york-fs/bms/README.md

# Battery Management System Segment Board





The distributed BMS segment board connects to a series string of 12 cells and can be queried over isolated I2C to sample
cell voltages and temperatures.

## Features

* **Isolated I2C Communication to the Master Board**
* **Accurate Voltage Measurement Using the MAX14920 Analog Frontend**
* **Passive Cell Balancing**
* **Up to 23 Connected Thermistors**
  * Three onboard thermistors around the cell balancers
  * Twenty external thermistors across two JST PUD connectors

Preview Render

## Cloning

A recursive clone must be used to download the `kicad-library` repository:

    git clone --recursive https://github.com/york-fs/bms-segment.git
