york-fs/bms/bms_segment.kicad_pcb

## KiCad design bms_segment.kicad_pcb (2025-10-20)

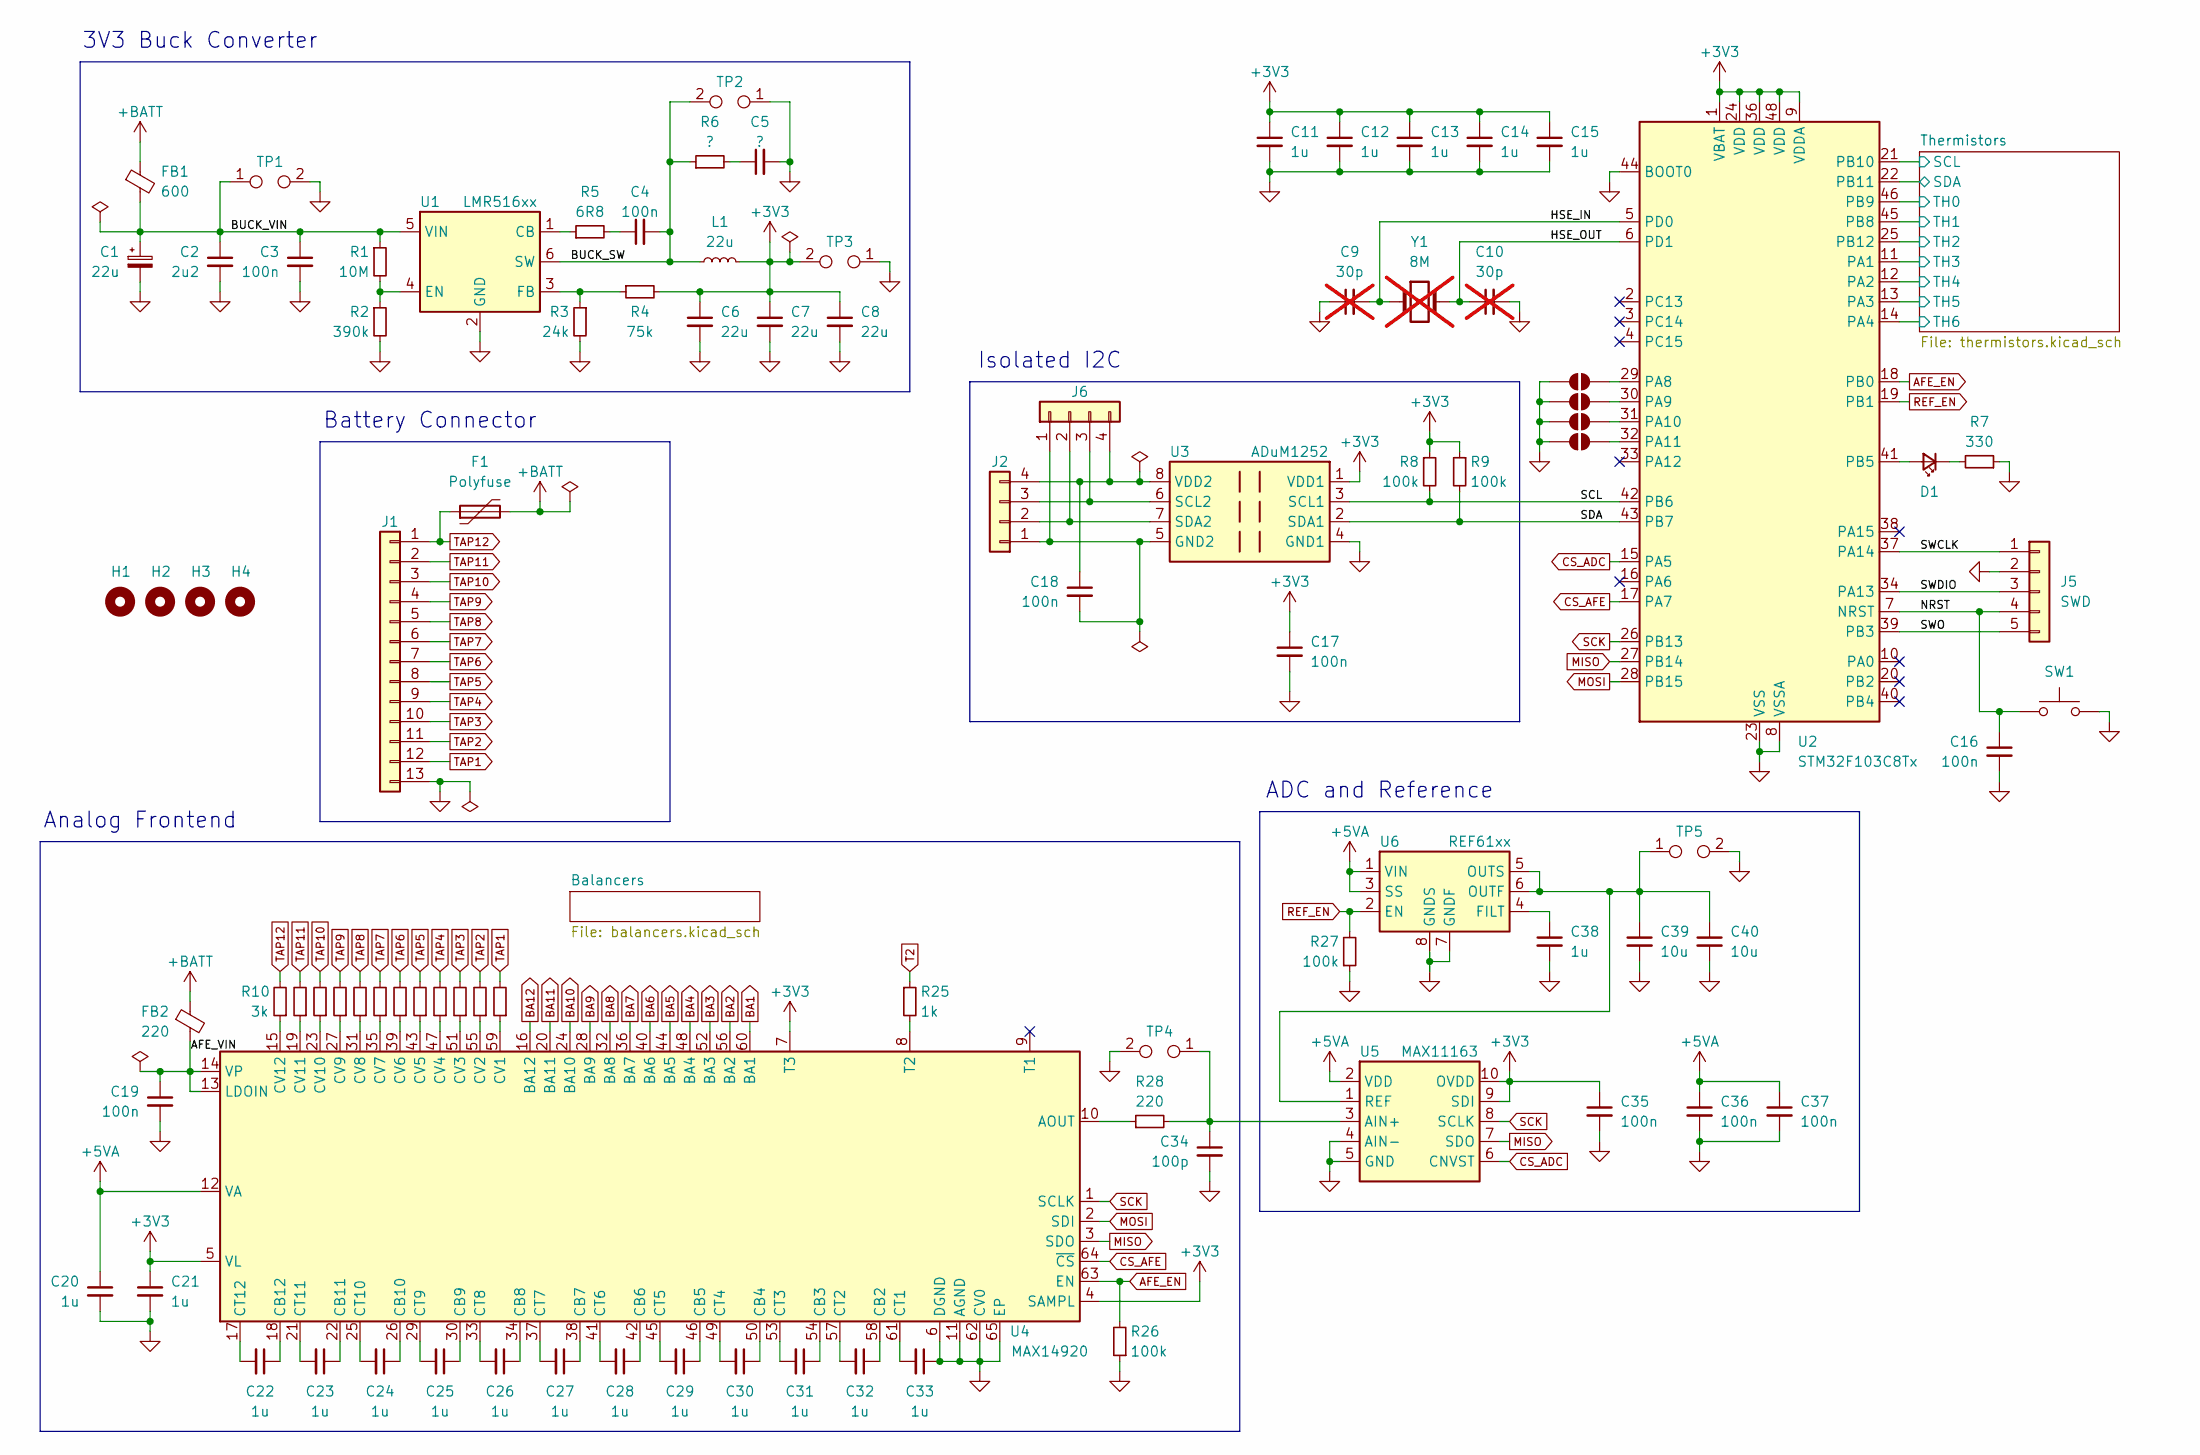
[picture p1: schematic bms_segment.kicad_sch, Battery Management System]

Parts:
C1: 22u; CP_Elec_6.3x7.7; Mfr # EEEFK1J220XP
C2: 2u2; C_1210_3225Metric; Mfr # GRM32ER72A225KA35
C3, C19: 100n; C_1206_3216Metric; Mfr # GRM31C5C2A104JA01L
C4, C16, C17, C18, C35, C36, C37: 100n; C_0603_1608Metric; Mfr # CL10B104KB8NNNC
C5: ?; C_0603_1608Metric
C6, C7, C8: 22u; C_1210_3225Metric; Mfr # GRM32ER71E226KE15L
C9, C10: 30p; C_0603_1608Metric; Mfr # GQM1875C2E300GB12D; not fitted
C11, C12, C13, C14, C15, C20, C21, C38: 1u; C_0603_1608Metric; Mfr # CL10B105KB8NQNC
C22, C23, C24, C25, C26, C27, C28, C29, C30, C31, C32, C33: 1u; C_0805_2012Metric; Mfr # GCM21BR71H105KA03L
C34: 100p; C_0603_1608Metric
C39, C40: 10u; C_1206_3216Metric; Mfr # GRM31CR71C106KA12L
D1: LED_Small; LED_0603_1608Metric; Mfr # NCD0603R1
F1: Polyfuse; R_1206_3216Metric; Mfr # 1206L010/60WR
FB1: 600; L_0603_1608Metric; Mfr # BLM18KG601SN1D
FB2: 220; L_0603_1608Metric; Mfr # BLM18PG221SN1D
H1, H2, H3, H4: MountingHole; MountingHole_3.2mm_M3
J1: CELL_TAPS; PhoenixContact_MC_1,5_13-G-3.81_1x13_P3.81mm_Horizontal; Mfr # MX15EDGRC-3.81-13P-GN01-Cu-A
J2, J6: I2C; JST_PH_B4B-PH-K_1x04_P2.00mm_Vertical; Mfr # B4B-PH-K-S(LF)(SN)
J5: SWD; PinHeader_1x05_P2.54mm_Vertical
JP1, JP2, JP3, JP4: SolderJumper_2_Open; SolderJumper-2_P1.3mm_Open_RoundedPad1.0x1.5mm
L1: 22u; L_Vishay_IHLP-2525; Mfr # IHLP2525CZER220M1A
R1: 10M; R_0603_1608Metric
R2: 390k; R_0603_1608Metric
R3: 24k; R_0603_1608Metric
R4: 75k; R_0603_1608Metric
R5: 6R8; R_0603_1608Metric
R6: ?; R_0603_1608Metric
R7: 330; R_0603_1608Metric; Mfr # 0603WAF3300T5E
R8, R9, R26, R27: 100k; R_0603_1608Metric; Mfr # 0603WAF1003T5E
R10, R11, R12, R13, R14, R15, R16, R17, R18, R19, R20, R21: 3k; R_0603_1608Metric; Mfr # 0603WAF3001T5E
R25: 1k; R_0603_1608Metric; Mfr # 0603WAF1001T5E
R28: 220; R_0603_1608Metric
SW1: SW_Push; SW_Push_SPST_NO_Alps_SKRK; Mfr # TS-1088-AR02016
TP1, TP2, TP3, TP4, TP5: TestPoint_2Pole; TestPoint_2Pads_Pitch2.54mm_Drill1.0mm
U1: LMR516xx; SOT-23-6; Mfr # LMR51606XDBVR
U2: STM32F103C8Tx; LQFP-48_7x7mm_P0.5mm; Mfr # STM32F103C8T6
U3: ADuM1252; MSOP-8_3x3mm_P0.65mm; Mfr # ADUM1252AUA+
U4: MAX14920; TQFP-64-1EP_10x10mm_P0.5mm_EP5.305x5.305mm; Mfr # MAX14920ECB+
U5: MAX11163; MSOP-10_3x3mm_P0.5mm; Mfr # MAX11163EUB+
U6: REF61xx; VSSOP-8_3x3mm_P0.65mm; Mfr # REF6145IDGKT
Y1: 8M; Crystal_SMD_5032-2Pin_5.0x3.2mm; Mfr # X50328MSB2GI; not fitted

Connections:
+3V3: C6.1, C7.1, C8.1, C11.1, C12.1, C13.1, C14.1, C15.1, C17.1, C21.1, C35.1, L1.2, R4.2, R8.1, R9.1, TP3.2, U2.1 (VBAT), U2.9 (VDDA), U2.24 (VDD), U2.36 (VDD), U2.48 (VDD), U3.1 (VDD1), U4.4 (SAMPL), U4.5 (VL), U4.7 (T3), U5.9 (SDI), U5.10 (OVDD); also elsewhere on the board
+5VA: C20.1, C36.1, C37.1, U4.12 (VA), U5.2 (VDD), U6.1 (VIN), U6.3 (SS)
+BATT: F1.2, FB1.1, FB2.1
/AFE_VIN: C19.1, FB2.2, U4.13 (LDOIN), U4.14 (VP)
/BUCK_SW: C4.2, L1.1, R6.1, TP2.2, U1.6 (SW)
/BUCK_VIN: C1.1, C2.1, C3.1, FB1.2, R1.1, TP1.1, U1.5 (VIN)
/HSE_IN: C9.2, U2.5 (PD0), Y1.1
/HSE_OUT: C10.1, U2.6 (PD1), Y1.2
/NRST: C16.1, J5.4, SW1.1, U2.7 (NRST)
/SCL: R8.2, U2.42 (PB6), U3.3 (SCL1)
/SDA: R9.2, U2.43 (PB7), U3.2 (SDA1)
/SWCLK: J5.1, U2.37 (PA14)
/SWDIO: J5.3, U2.34 (PA13)
/SWO: J5.5, U2.39 (PB3)
/Thermistors/SCL: U2.21 (PB10); also elsewhere on the board
/Thermistors/SDA: U2.22 (PB11); also elsewhere on the board
/Thermistors/TH0: U2.46 (PB9); also elsewhere on the board
/Thermistors/TH1: U2.45 (PB8); also elsewhere on the board
/Thermistors/TH2: U2.25 (PB12); also elsewhere on the board
/Thermistors/TH3: U2.11 (PA1); also elsewhere on the board
/Thermistors/TH4: U2.12 (PA2); also elsewhere on the board
/Thermistors/TH5: U2.13 (PA3); also elsewhere on the board
/Thermistors/TH6: U2.14 (PA4); also elsewhere on the board
AFE_EN: R26.2, U2.18 (PB0), U4.63 (EN)
BA1: U4.60 (BA1); also elsewhere on the board
BA2: U4.56 (BA2); also elsewhere on the board
BA3: U4.52 (BA3); also elsewhere on the board
BA4: U4.48 (BA4); also elsewhere on the board
BA5: U4.44 (BA5); also elsewhere on the board
BA6: U4.40 (BA6); also elsewhere on the board
BA7: U4.36 (BA7); also elsewhere on the board
BA8: U4.32 (BA8); also elsewhere on the board
BA9: U4.28 (BA9); also elsewhere on the board
BA10: U4.24 (BA10); also elsewhere on the board
BA11: U4.20 (BA11); also elsewhere on the board
BA12: U4.16 (BA12); also elsewhere on the board
CS_ADC: U2.15 (PA5), U5.6 (CNVST)
CS_AFE: U2.17 (PA7), U4.64 (~CS)
GND: C1.2, C2.2, C3.2, C5.2, C6.2, C7.2, C8.2, C9.1, C10.2, C11.2, C12.2, C13.2, C14.2, C15.2, C16.2, C17.2, C19.2, C20.2, C21.2, C33.1, C34.2, C35.2, C36.2, C37.2, C38.2, C39.2, C40.2, J1.13, J5.2, JP1.1 (A), JP2.1 (A), JP3.1 (A), JP4.1 (A), R2.2, R3.2, R7.1, R26.1, R27.1, SW1.2, TP1.2, TP2.1, TP3.1, TP4.2, TP5.2, U1.2 (GND), U2.8 (VSSA), U2.23 (VSS), U2.35 (VSS), U2.44 (BOOT0), U2.47 (VSS), U3.4 (GND1), U4.6 (DGND), U4.11 (AGND), U4.62 (CV0), U4.65 (EP), U5.4 (AIN-), U5.5 (GND), U6.7 (GNDF), U6.8 (GNDS); also elsewhere on the board
MISO: U2.27 (PB14), U4.3 (SDO), U5.7 (SDO)
MOSI: U2.28 (PB15), U4.2 (SDI)
unnamed: C4.1, R5.2
unnamed: C5.1, R6.2
unnamed: D1.2 (A), U2.41 (PB5)
unnamed: D1.1 (K), R7.2
unnamed: C18.2, J2.1, J6.1, U3.5 (GND2)
unnamed: J2.2, J6.2, U3.7 (SDA2)
unnamed: J2.3, J6.3, U3.6 (SCL2)
unnamed: C18.1, J2.4, J6.4, U3.8 (VDD2)
unnamed: JP1.2 (B), U2.29 (PA8)
unnamed: JP2.2 (B), U2.30 (PA9)
unnamed: JP3.2 (B), U2.31 (PA10)
unnamed: JP4.2 (B), U2.32 (PA11)
unnamed: R5.1, U1.1 (CB)
unnamed: R1.2, R2.1, U1.4 (EN)
unnamed: R3.1, R4.1, U1.3 (FB)
unnamed: R28.1, U4.10 (AOUT)
unnamed: C32.1, U4.58 (CB2)
unnamed: C31.1, U4.54 (CB3)
unnamed: C30.1, U4.50 (CB4)
unnamed: C29.1, U4.46 (CB5)
unnamed: C28.1, U4.42 (CB6)
unnamed: C27.1, U4.38 (CB7)
unnamed: C26.1, U4.34 (CB8)
unnamed: C25.1, U4.30 (CB9)
unnamed: C24.1, U4.26 (CB10)
unnamed: C23.1, U4.22 (CB11)
unnamed: C22.1, U4.18 (CB12)
unnamed: C33.2, U4.61 (CT1)
unnamed: C32.2, U4.57 (CT2)
unnamed: C31.2, U4.53 (CT3)
unnamed: C30.2, U4.49 (CT4)
unnamed: C29.2, U4.45 (CT5)
unnamed: C28.2, U4.41 (CT6)
unnamed: C27.2, U4.37 (CT7)
unnamed: C26.2, U4.33 (CT8)
unnamed: C25.2, U4.29 (CT9)
unnamed: C24.2, U4.25 (CT10)
unnamed: C23.2, U4.21 (CT11)
unnamed: C22.2, U4.17 (CT12)
unnamed: R21.1, U4.59 (CV1)
unnamed: R20.1, U4.55 (CV2)
unnamed: R19.1, U4.51 (CV3)
unnamed: R18.1, U4.47 (CV4)
unnamed: R17.1, U4.43 (CV5)
unnamed: R16.1, U4.39 (CV6)
unnamed: R15.1, U4.35 (CV7)
unnamed: R14.1, U4.31 (CV8)
unnamed: R13.1, U4.27 (CV9)
unnamed: R12.1, U4.23 (CV10)
unnamed: R11.1, U4.19 (CV11)
unnamed: R10.1, U4.15 (CV12)
unnamed: R25.2, U4.8 (T2)
unnamed: C34.1, R28.2, TP4.1, U5.3 (AIN+)
unnamed: C39.1, C40.1, TP5.1, U5.1 (REF), U6.5 (OUTS), U6.6 (OUTF)
unnamed: C38.1, U6.4 (FILT)
REF_EN: R27.2, U2.19 (PB1), U6.2 (EN)
SCK: U2.26 (PB13), U4.1 (SCLK), U5.8 (SCLK)
T2: R25.1; also elsewhere on the board
TAP1: J1.12, R21.2; also elsewhere on the board
TAP2: J1.11, R20.2; also elsewhere on the board
TAP3: J1.10, R19.2; also elsewhere on the board
TAP4: J1.9, R18.2; also elsewhere on the board
TAP5: J1.8, R17.2; also elsewhere on the board
TAP6: J1.7, R16.2; also elsewhere on the board
TAP7: J1.6, R15.2; also elsewhere on the board
TAP8: J1.5, R14.2; also elsewhere on the board
TAP9: J1.4, R13.2; also elsewhere on the board
TAP10: J1.3, R12.2; also elsewhere on the board
TAP11: J1.2, R11.2; also elsewhere on the board
TAP12: F1.1, J1.1, R10.2; also elsewhere on the board

Notes on the sheet:
ADC and Reference
Isolated I2C
3V3 Buck Converter
Analog Frontend
Battery Connector

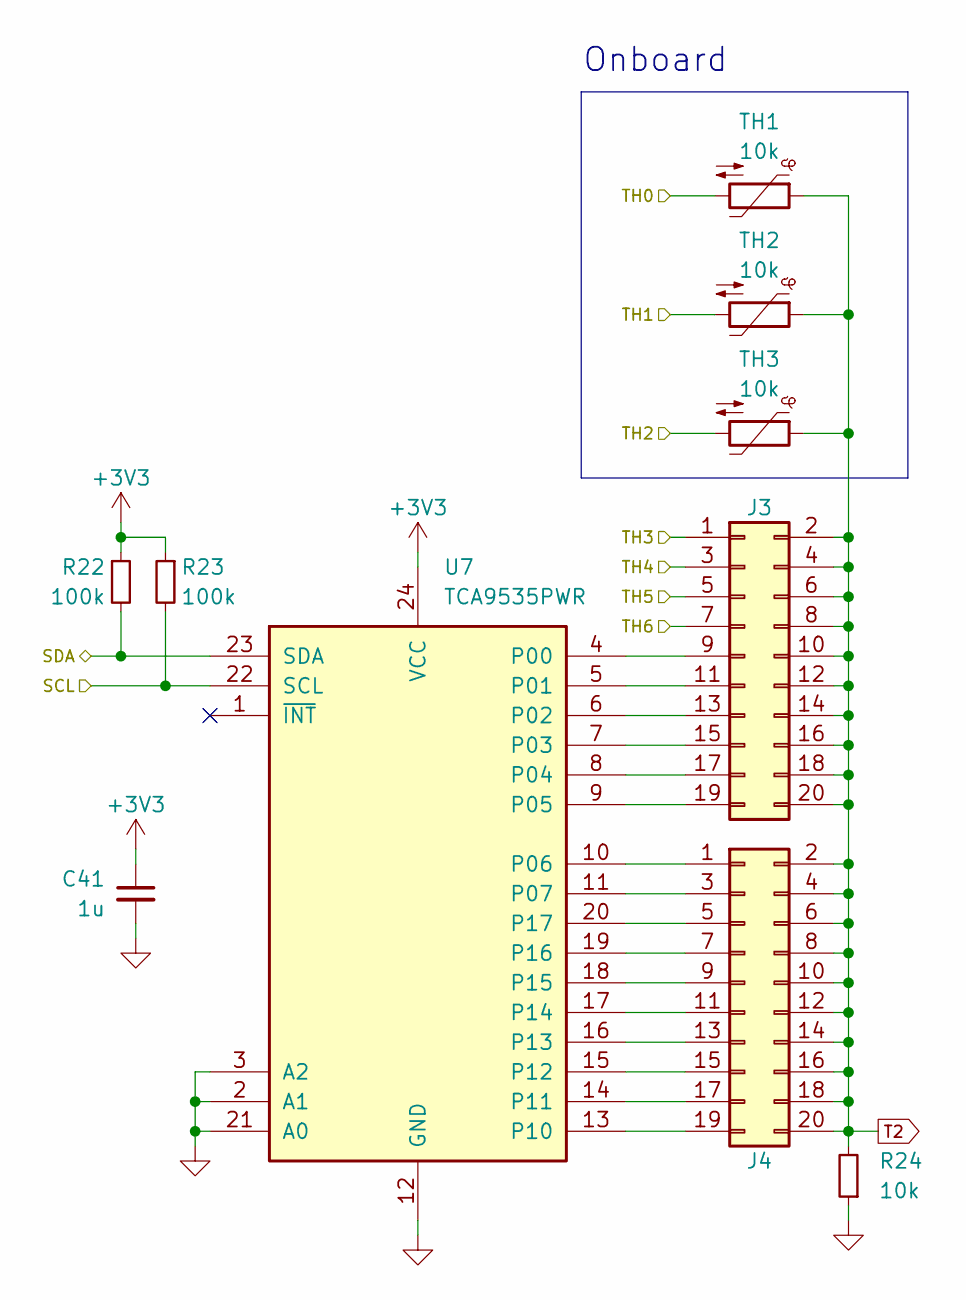
[picture p2: schematic thermistors.kicad_sch, Battery Management System]

Parts:
C41: 1u; C_0603_1608Metric; Mfr # CL10B105KB8NQNC
J3: THERM_1; JST_PUD_S20B-PUDSS-1_2x10_P2.00mm_Horizontal; Mfr # S20B-PUDSS-1(LF)(SN)
J4: THERM_2; JST_PUD_S20B-PUDSS-1_2x10_P2.00mm_Horizontal; Mfr # S20B-PUDSS-1(LF)(SN)
R22, R23: 100k; R_0603_1608Metric; Mfr # 0603WAF1003T5E
R24: 10k; R_0603_1608Metric; Mfr # 0603WAF1002T5E
TH1, TH2, TH3: 10k; R_0603_1608Metric; Mfr # NCP18XH103F03RB
U7: TCA9535PWR; TSSOP-24_4.4x7.8mm_P0.65mm; Mfr # TCA9535PWR

Connections:
+3V3: C41.1, R22.1, R23.1, U7.24 (VCC); also elsewhere on the board
/Thermistors/SCL: R23.2, U7.22 (SCL); also elsewhere on the board
/Thermistors/SDA: R22.2, U7.23 (SDA); also elsewhere on the board
/Thermistors/TH0: TH1.2; also elsewhere on the board
/Thermistors/TH1: TH2.2; also elsewhere on the board
/Thermistors/TH2: TH3.2; also elsewhere on the board
/Thermistors/TH3: J3.1; also elsewhere on the board
/Thermistors/TH4: J3.3; also elsewhere on the board
/Thermistors/TH5: J3.5; also elsewhere on the board
/Thermistors/TH6: J3.7; also elsewhere on the board
GND: C41.2, R24.1, U7.2 (A1), U7.3 (A2), U7.12 (GND), U7.21 (A0); also elsewhere on the board
unnamed: J3.9, U7.4 (P00)
unnamed: J3.11, U7.5 (P01)
unnamed: J3.13, U7.6 (P02)
unnamed: J3.15, U7.7 (P03)
unnamed: J3.17, U7.8 (P04)
unnamed: J3.19, U7.9 (P05)
unnamed: J4.1, U7.10 (P06)
unnamed: J4.3, U7.11 (P07)
unnamed: J4.5, U7.20 (P17)
unnamed: J4.7, U7.19 (P16)
unnamed: J4.9, U7.18 (P15)
unnamed: J4.11, U7.17 (P14)
unnamed: J4.13, U7.16 (P13)
unnamed: J4.15, U7.15 (P12)
unnamed: J4.17, U7.14 (P11)
unnamed: J4.19, U7.13 (P10)
T2: J3.2, J3.4, J3.6, J3.8, J3.10, J3.12, J3.14, J3.16, J3.18, J3.20, J4.2, J4.4, J4.6, J4.8, J4.10, J4.12, J4.14, J4.16, J4.18, J4.20, R24.2, TH1.1, TH2.1, TH3.1; also elsewhere on the board

Notes on the sheet:
Onboard

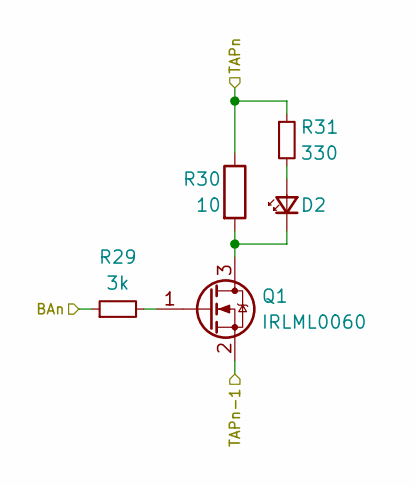
[picture p3: schematic balance.kicad_sch, Battery Management System]

Parts:
D2: LED_Small; LED_0603_1608Metric; Mfr # NCD0603R1
Q1: IRLML0060; SOT-23; Mfr # IRLML0060TRPBF
R29: 3k; R_0603_1608Metric; Mfr # 0603WAF3001T5E
R30: 10; R_2512_6332Metric; Mfr # RPL-12K10R0FT
R31: 330; R_0603_1608Metric; Mfr # 0603WAF3300T5E

Connections:
BA1: R29.1; also elsewhere on the board
GND: Q1.2 (S); also elsewhere on the board
unnamed: D2.2 (A), R31.2
unnamed: D2.1 (K), Q1.3 (D), R30.2
unnamed: Q1.1 (G), R29.2
TAP1: R30.1, R31.1; also elsewhere on the board

Parts of its further copies:
D3, D4, D5, D6, D7, D8, D9, D10, D11, D12, D13: LED_Small; LED_0603_1608Metric; Mfr # NCD0603R1
Q2, Q3, Q4, Q5, Q6, Q7, Q8, Q9, Q10, Q11, Q12: IRLML0060; SOT-23; Mfr # IRLML0060TRPBF
R32, R35, R38, R41, R44, R47, R50, R53, R56, R59, R62: 3k; R_0603_1608Metric; Mfr # 0603WAF3001T5E
R33, R36, R39, R42, R45, R48, R51, R54, R57, R60, R63: 10; R_2512_6332Metric; Mfr # RPL-12K10R0FT
R34, R37, R40, R43, R46, R49, R52, R55, R58, R61, R64: 330; R_0603_1608Metric; Mfr # 0603WAF3300T5E

Connections of its further copies:
BA2: R32.1; also elsewhere on the board
BA3: R35.1; also elsewhere on the board
BA4: R38.1; also elsewhere on the board
BA5: R41.1; also elsewhere on the board
BA6: R44.1; also elsewhere on the board
BA7: R47.1; also elsewhere on the board
BA8: R50.1; also elsewhere on the board
BA9: R53.1; also elsewhere on the board
BA10: R56.1; also elsewhere on the board
BA11: R59.1; also elsewhere on the board
BA12: R62.1; also elsewhere on the board
unnamed: D3.2 (A), R34.2
unnamed: D3.1 (K), Q2.3 (D), R33.2
unnamed: D4.2 (A), R37.2
unnamed: D4.1 (K), Q3.3 (D), R36.2
unnamed: D5.2 (A), R40.2
unnamed: D5.1 (K), Q4.3 (D), R39.2
unnamed: D6.2 (A), R43.2
unnamed: D6.1 (K), Q5.3 (D), R42.2
unnamed: D7.2 (A), R46.2
unnamed: D7.1 (K), Q6.3 (D), R45.2
unnamed: D8.2 (A), R49.2
unnamed: D8.1 (K), Q7.3 (D), R48.2
unnamed: D9.2 (A), R52.2
unnamed: D9.1 (K), Q8.3 (D), R51.2
unnamed: D10.2 (A), R55.2
unnamed: D10.1 (K), Q9.3 (D), R54.2
unnamed: D11.2 (A), R58.2
unnamed: D11.1 (K), Q10.3 (D), R57.2
unnamed: D12.2 (A), R61.2
unnamed: D12.1 (K), Q11.3 (D), R60.2
unnamed: D13.2 (A), R64.2
unnamed: D13.1 (K), Q12.3 (D), R63.2
unnamed: Q2.1 (G), R32.2
unnamed: Q3.1 (G), R35.2
unnamed: Q4.1 (G), R38.2
unnamed: Q5.1 (G), R41.2
unnamed: Q6.1 (G), R44.2
unnamed: Q7.1 (G), R47.2
unnamed: Q8.1 (G), R50.2
unnamed: Q9.1 (G), R53.2
unnamed: Q10.1 (G), R56.2
unnamed: Q11.1 (G), R59.2
unnamed: Q12.1 (G), R62.2
TAP1: Q2.2 (S); also elsewhere on the board
TAP2: Q3.2 (S), R33.1, R34.1; also elsewhere on the board
TAP3: Q4.2 (S), R36.1, R37.1; also elsewhere on the board
TAP4: Q5.2 (S), R39.1, R40.1; also elsewhere on the board
TAP5: Q6.2 (S), R42.1, R43.1; also elsewhere on the board
TAP6: Q7.2 (S), R45.1, R46.1; also elsewhere on the board
TAP7: Q8.2 (S), R48.1, R49.1; also elsewhere on the board
TAP8: Q9.2 (S), R51.1, R52.1; also elsewhere on the board
TAP9: Q10.2 (S), R54.1, R55.1; also elsewhere on the board
TAP10: Q11.2 (S), R57.1, R58.1; also elsewhere on the board
TAP11: Q12.2 (S), R60.1, R61.1; also elsewhere on the board
TAP12: R63.1, R64.1; also elsewhere on the board

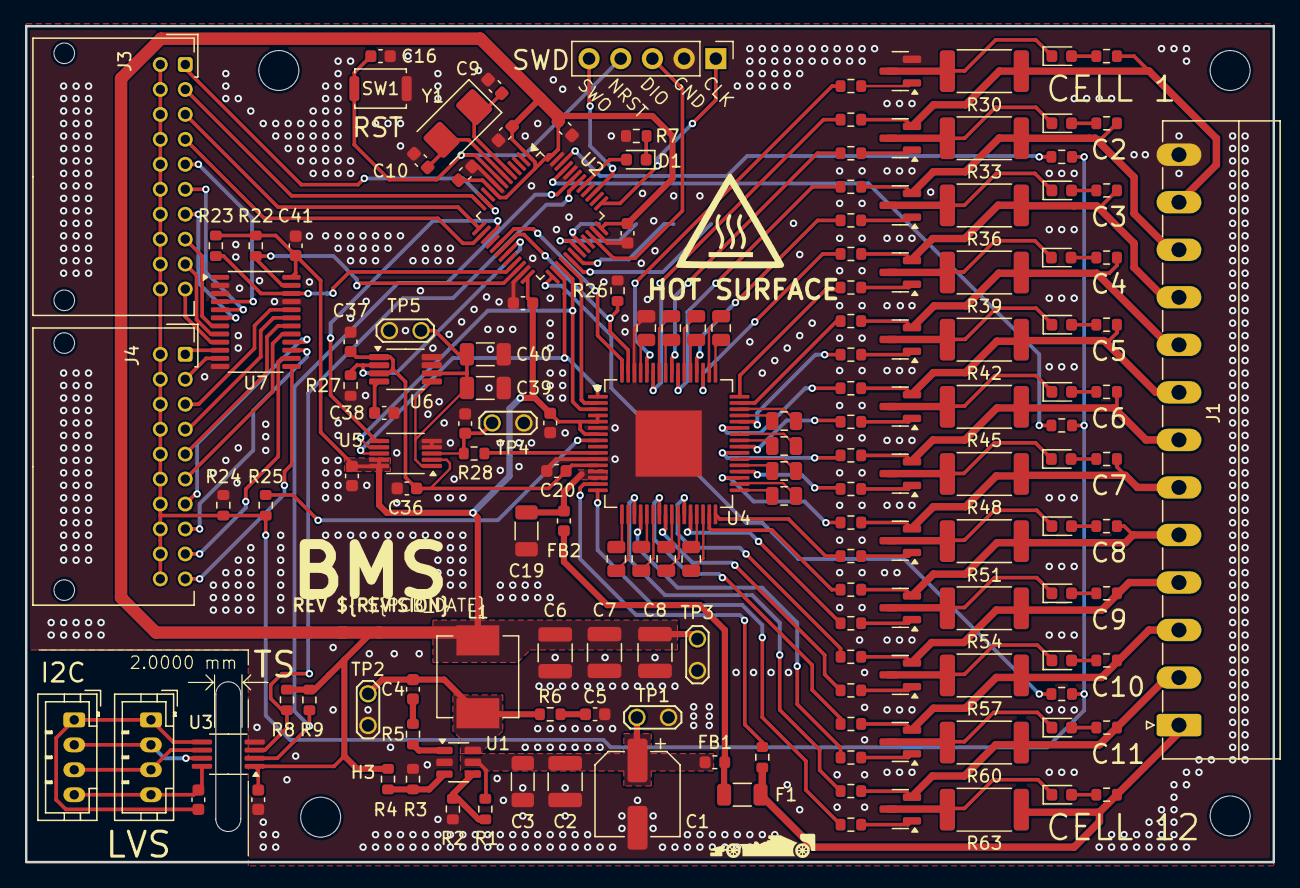
[picture p4: board bms_segment.kicad_pcb from above]

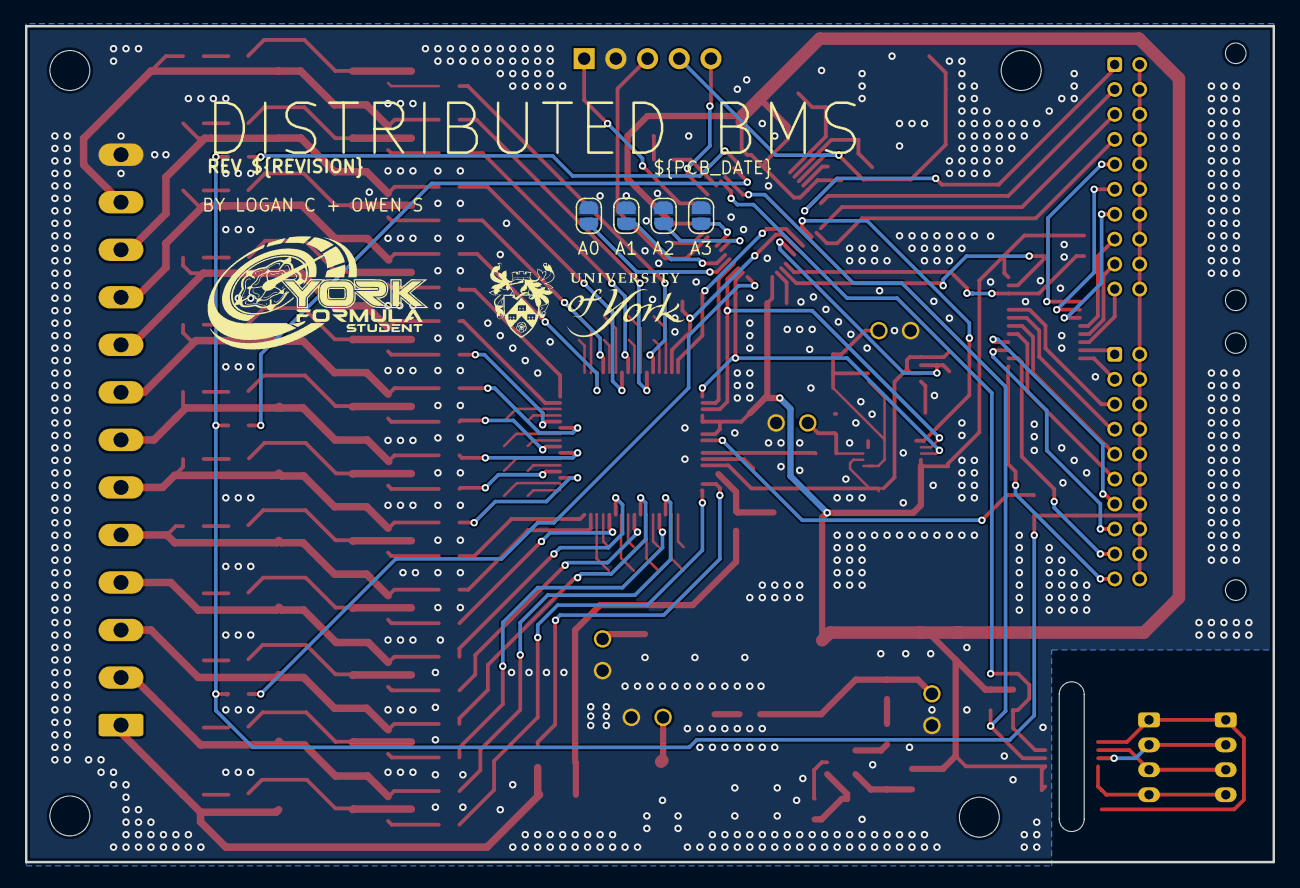
[picture p5: board bms_segment.kicad_pcb from below]

Board: 4 copper layers, 100.0 x 67.0 mm, 165 parts (4 on the bottom side), 163 nets.
