york-fs/bms/(threads)

Thread 9 (2025-03-31):

Move J1 (Cell Connector) closer to the board outline

lansraad, 2025-03-31:
Move the cell tap connector closer to the board outline for better clearance

Closed 2025-03-31.
