york-fs/bms/(commit log)

2025-02-04 schematic: Add buck regulator
    [bms.kicad_sch]
2025-02-05 schematic: Add more output capacitors to buck converter
    [bms.kicad_sch]
2025-02-05 schematic: Make buck converter 3.3 volt output
    [bms.kicad_sch]
2025-02-06 schematic: Some small buck changes
    [bms.kicad_sch]
2025-02-06 project: Update BOM fields
2025-02-06 schematic: Lots of progress on frontend
    [balance.kicad_sch, bms.kicad_sch]
2025-02-06 symbols: Add footprint filters for MAX11163 and MAX6216
2025-02-06 schematic: Assign some footprints
    [balance.kicad_sch, bms.kicad_sch]
2025-02-06 schematic: Instantiate all balancers
    [balance.kicad_sch, balancers.kicad_sch, bms.kicad_sch]
2025-02-06 schematic: Add BOM role
    [balance.kicad_sch, bms.kicad_sch]
2025-02-06 schematic: Add SWD header
    [bms.kicad_sch]
2025-02-06 schematic: Add mounting holes
    [bms.kicad_sch]
2025-02-07 schematic: Assign some more real components to passives
    [balance.kicad_sch, bms.kicad_sch]
2025-02-07 schematic: Add isolated I2C
    [bms.kicad_sch]
2025-02-08 schematic: Add thermistors
    [balancers.kicad_sch, bms.kicad_sch, thermistor.kicad_sch, thermistors.kicad_sch]
2025-02-08 schematic: MCU cleanup
    [bms.kicad_sch, thermistors.kicad_sch]
2025-02-08 schematic: Assign inductor footprint and part number
    [bms.kicad_sch]
2025-02-08 schematic: Fix some pin types to make ERC happy
    [bms.kicad_sch]
2025-02-08 schematic: Reorder pages
    [balancers.kicad_sch, bms.kicad_sch, thermistor.kicad_sch]
2025-02-08 schematic: Add input polyfuse
    [bms.kicad_sch]
2025-02-08 schematic: Add resistor to MAX14920 input
    [bms.kicad_sch]
2025-02-08 schematic: Add some ferrite beads
    [bms.kicad_sch]
2025-02-08 schematic: Assign remaining footprints
    [bms.kicad_sch]
2025-02-08 schematic: Add some more test points
    [bms.kicad_sch]
2025-02-08 schematic: Cleanup
    [balance.kicad_sch, balancers.kicad_sch, bms.kicad_sch, thermistor.kicad_sch, thermistors.kicad_sch]
2025-02-08 schematic: Re-annotate designators
    [balance.kicad_sch, balancers.kicad_sch, bms.kicad_sch, thermistor.kicad_sch, thermistors.kicad_sch]
2025-02-08 symbols: Add exposed pad pin on MAX14920
    [bms.kicad_sch]
2025-02-08 pcb: Create outline
    [bms.kicad_pcb]
2025-02-09 schematic: Switch to 3.81 mm pitch connector for cell taps
    Also fix footprint.
    [bms.kicad_sch]
2025-02-09 schematic: Add some net labels
    [bms.kicad_sch]
2025-02-09 schematic: Use smaller 2-pole test points
    [bms.kicad_sch]
2025-02-18 models: Add step files for inductor and PUD connector
    [L_Vishay_IHLP-2525.step, S20B-PUDSS-1.step]
2025-02-18 schematic: Don't make CV12 go through fuse and adjust thermistor pinout
    [balancers.kicad_sch, bms.kicad_sch, thermistor.kicad_sch, thermistors.kicad_sch]
2025-02-18 schematic: Remove I2C_OUT connector
    [bms.kicad_sch, thermistors.kicad_sch]
2025-02-18 pcb: Revert to blank PCB
    [bms.kicad_pcb]
2025-02-21 schematic: Reduce down to two thermistor connectors
    [bms.kicad_sch, thermistor.kicad_sch, thermistors.kicad_sch]
2025-02-22 schematic: Cleanup BOM
    [balance.kicad_sch, bms.kicad_sch, thermistor.kicad_sch, thermistors.kicad_sch]
2025-02-22 schematic: Remove 1n decoupling capacitors for I2C
    [bms.kicad_sch]
2025-03-03 pcb: Create first PCB revision
    [bms.kicad_pcb, bms.kicad_sch, thermistors.kicad_sch]
2025-03-03 pcb: Fill in info box
    [bms.kicad_pcb]
2025-03-03 pcb: Update to kicad 8.0.9
    [bms.kicad_pcb]
2025-03-03 pcb: Fix DRC errors and add more GND vias
    [bms.kicad_pcb]
2025-03-03 pcb: Set gerber output parameters
    [bms.kicad_pcb]
2025-03-03 pcb: Add more GND vias near reference and ADC
    [bms.kicad_pcb]
2025-03-03 pcb: Remove extra reference OUTS trace
    [bms.kicad_pcb]
2025-03-03 pcb: Cleanup tracks
    [bms.kicad_pcb]
2025-03-23 *: Update to kicad 9.0.0
    [balance.kicad_sch, balancers.kicad_sch, bms.kicad_pcb, bms.kicad_sch, thermistor.kicad_sch, thermistors.kicad_sch]
2025-03-23 pcb: Move some close traces
    [bms.kicad_pcb]
2025-03-23 *: Tie AFE SAMPL pin always high
    Closes GH-2
    [bms.kicad_pcb, bms.kicad_sch]
2025-03-23 pcb: Ungroup GND vias
    [bms.kicad_pcb]
2025-03-23 pcb: Reduce TAP12 trace width from 1 mm to 0.6 mm
    [bms.kicad_pcb]
2025-03-23 pcb: Move cell tap connector towards board edge by 0.3 mm
    Closes GH-1
    [bms.kicad_pcb]
2025-03-23 pcb: Use a filled zone for AFE_VIN
    [bms.kicad_pcb]
2025-03-23 pcb: Cleanup GND vias
    [bms.kicad_pcb]
2025-03-23 pcb: Remove unconnected track piece
    [bms.kicad_pcb]
2025-03-23 pcb: Run cleanup graphics
    [bms.kicad_pcb]
2025-03-31 *: Remove thermistor protection zener diodes
    Closes GH-8
    [balance.kicad_sch, bms.kicad_pcb, bms.kicad_sch]
2025-03-31 *: Fix whitespace in BOM
    [bms.kicad_pcb, bms.kicad_sch, thermistors.kicad_sch]
2025-03-31 *: Add a pull-down on the MAX14920 enable pin
    Closes GH-13
    [bms.kicad_pcb, bms.kicad_sch]
2025-03-31 *: Change MCU LED pin
    Closes GH-3
    [bms.kicad_pcb, bms.kicad_sch]
2025-03-31 *: Mark MCU crystal as DNP
    Closes GH-6
    [bms.kicad_pcb, bms.kicad_sch]
2025-03-31 pcb: Add some more GND vias around the MCU
    [bms.kicad_pcb]
2025-03-31 pcb: Move cell tap connector another 0.7 mm towards the board edge
    For a total of 1 mm. Closes GH-9
    [bms.kicad_pcb]
2025-03-31 *: Use a more suitable footprint for the MAX14920
    This one has a more correct exposed pad size. Closes GH-4
    [bms.kicad_pcb, bms.kicad_sch]
2025-03-31 pcb: Give the vias around MAX14920 more space
    [bms.kicad_pcb]
2025-03-31 *: Change buck enable pin potential divider values
    Closes GH-12
    [bms.kicad_pcb, bms.kicad_sch]
2025-03-31 *: Switch to the REF6145 reference
    Closes GH-7
    [bms.kicad_pcb, bms.kicad_sch]
2025-03-31 footprints: Add a 1 mm hole test point footprint
2025-03-31 *: Use new test point footprint
    Closes GH-11
    [bms.kicad_pcb, bms.kicad_sch]
2025-03-31 pcb: Fix some ground islands
    [bms.kicad_pcb]
2025-03-31 *: Bump revision
    [balance.kicad_sch, balancers.kicad_sch, bms.kicad_pcb, bms.kicad_sch, thermistor.kicad_sch, thermistors.kicad_sch]
2025-03-31 Cleaned up silkscreen
    [bms.kicad_pcb]
2025-04-07 pcb: Rename AMS to BMS
    [bms.kicad_pcb]
2025-04-07 *: Use a variable for the revision number
    Closes GH-14
    [balance.kicad_sch, balancers.kicad_sch, bms.kicad_pcb, bms.kicad_sch, thermistor.kicad_sch, thermistors.kicad_sch]
2025-04-13 pcb: Fix slightly misaligned silkscreen
    [bms.kicad_pcb]
2025-04-13 *: Add solder jumpers for I2C address select
    [bms.kicad_pcb, bms.kicad_sch]
2025-04-13 pcb: Improve I2C address select silkscreen
    [bms.kicad_pcb]
2025-04-13 pcb: Move some tracks and vias to reduce missing ground fill
    [bms.kicad_pcb]
2025-04-14 schematic: Update value for buck converter bootstrap resistor
    [bms.kicad_pcb, bms.kicad_sch]
2025-04-15 symbols: Add symbol for IRLML0060 MOSFET
2025-04-15 *: Use IRLML0060 for the balance MOSFETs
    [balance.kicad_sch, bms.kicad_pcb]
2025-04-15 bom: Update incorrect on-board thermistor part number
    [bms.kicad_pcb, thermistors.kicad_sch]
2025-04-15 symbols: Add symbol for FDV303N MOSFET
2025-04-15 *: Use FDV303N for the thermistor MOSFETs
    [bms.kicad_pcb, thermistor.kicad_sch]
2025-04-15 *: Use 0805 package for the sampling capacitors
    Closes GH-15
    [bms.kicad_pcb, bms.kicad_sch]
2025-04-15 *: Use two vertical JST PH connectors for I2C
    [bms.kicad_pcb, bms.kicad_sch]
2025-04-15 *: Bump to revision C
    [balance.kicad_sch, balancers.kicad_sch, bms.kicad_pcb, bms.kicad_sch, thermistor.kicad_sch, thermistors.kicad_sch]
2025-05-11 *: Use a GPIO expander for the thermistors
    [balance.kicad_sch, balancers.kicad_sch, bms.kicad_pcb, bms.kicad_sch, thermistors.kicad_sch]
2025-06-11 schematic: Update to new kicad symbol library
    [balance.kicad_sch, bms.kicad_pcb, bms.kicad_sch, thermistors.kicad_sch]
2025-06-11 pcb: Update SOT-23 footprint to latest in kicad
    [bms.kicad_pcb]
2025-06-11 pcb: Update remaining footprint library references
    [bms.kicad_pcb]
2025-06-11 pcb: Add a variable for the silkscreen date
    [bms.kicad_pcb]
2025-06-11 *: Tie T3 to 3V3
    [bms.kicad_pcb, bms.kicad_sch]
2025-09-28 meta: Add kicad-library submodule
2025-09-28 pcb: Update 3D model paths
    [bms.kicad_pcb]
2025-09-28 meta: Delete old models
    [L_Vishay_IHLP-2525.step, S20B-PUDSS-1.step]
2025-09-28 schematic: Update to new symbol library
    [balance.kicad_sch, bms.kicad_sch]
2025-09-28 pcb: Update to new kicad libraries
    [bms.kicad_pcb]
2025-09-28 *: Remove project footprint library
    [bms.kicad_pcb, bms.kicad_sch]
2025-10-05 meta: Update kicad-library and gitignore
2025-10-05 meta: Set kicad-library branch
2025-10-11 kicad-library: Update to latest
2025-10-13 meta: Rename project to bms-segment
    [bms_segment.kicad_pcb, bms_segment.kicad_sch]
2025-10-20 bom: Remove spaces from part numbers
    [bms_segment.kicad_pcb, bms_segment.kicad_sch]
